DylanCoon99/multi-axis-arm/mechanical_design/gripper_ideas/gripper_3-1024x805.png

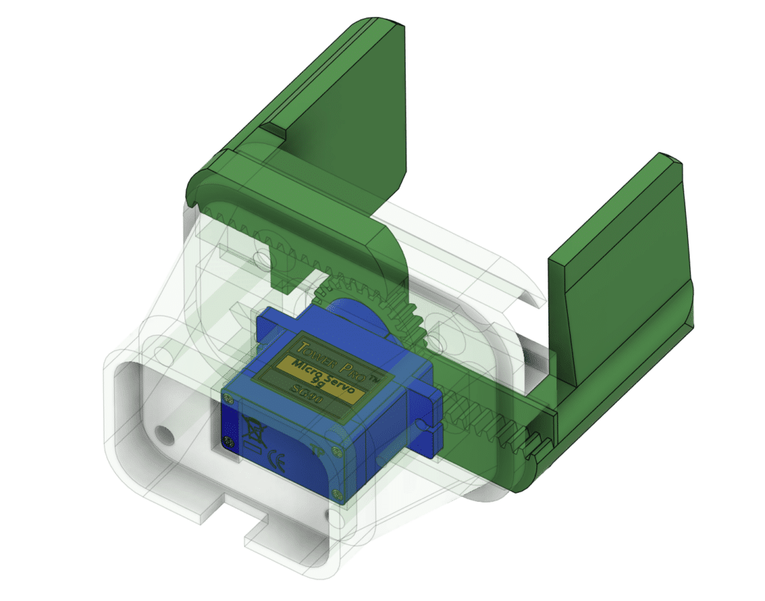
mechanical_design/gripper_ideas/gripper_3-1024x805.png
