DylanCoon99/multi-axis-arm/component_weights.xlsx

Component Weight Log — Week 1 Torque Calculation
Component | Estimated (g) | Measured (g) | Notes
Actuators
NEMA 17 stepper |  |  | Sits on base — not in torque calc
MG996R servo #1 (J2 shoulder) | 55 | 55
MG996R servo #2 (J2 shoulder) | 55 | 55
MG996R servo #3 (J3 elbow) | 55 | 55
SG90 / MG90S servo (gripper) | 9 | 9 | SG90 ~9g, MG90S ~13g
Spare MG996R |  |  | Not installed — exclude from calc
Structural (printed parts)
Upper arm link | 60 | 60 | Estimate — weigh after printing
Forearm link | 50 | 50 | Estimate — weigh after printing
Shoulder fork / joint housing
Elbow fork / joint housing
Gripper assembly (jaws + mount) | 70 | 70 | Total with servo
Base disc (printed pulley) |  |  | Not in torque calc
Base plate |  |  | Not in torque calc
Hardware
608ZZ bearing x2 |  | 12 | ~12g each
Metal servo horn x2
M3 fasteners (per joint, approx)
8mm stub shafts x2
Belt Drive (base — not in torque calc)
GT2 belt segment
20T GT2 pulley x2
Payload
Test object — light | 25
Test object — medium | 50
Test object — heavy | 100
Shoulder Torque Calculation (J2, dual MG996R) — Fill in after weighing
Upper arm link | 50 | 60
Elbow servo (MG996R) | 55 | 120
Forearm link | 50 | 185
Gripper assembly | 50 | 250
Payload | 50 | 260
TOTAL at shoulder | 50 | 270
Budget (50% of dual MG996R rating) |  |  | 10.00
Margin (positive = OK)
Margin (positive = OK)
