DylanCoon99/multi-axis-arm/mechanical_design/gcode/Arm Base.3mf

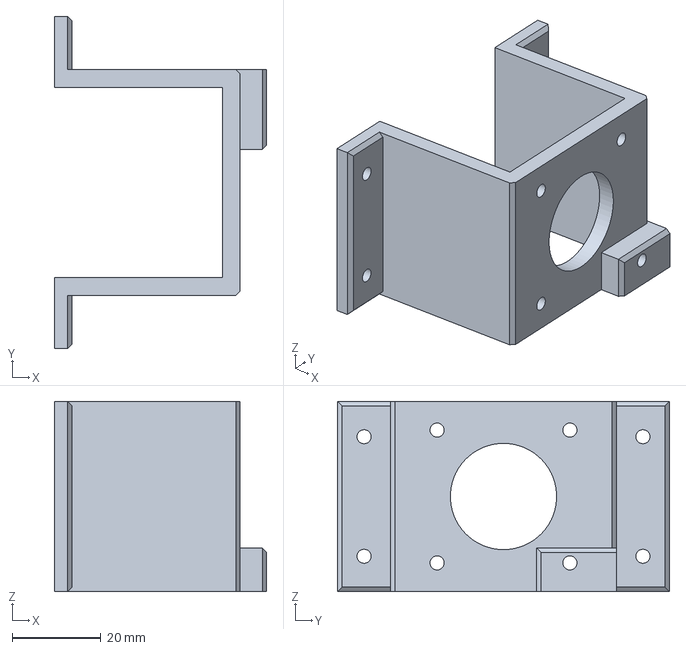
[picture p2: CAD file, 2026-09-03]
mechanical_design/gcode/Arm Base.3mf
48.0 x 75.0 x 43.0 mm
