DylanCoon99/multi-axis-arm/mechanical_design/projects/rack_and_pinion_test.3mf

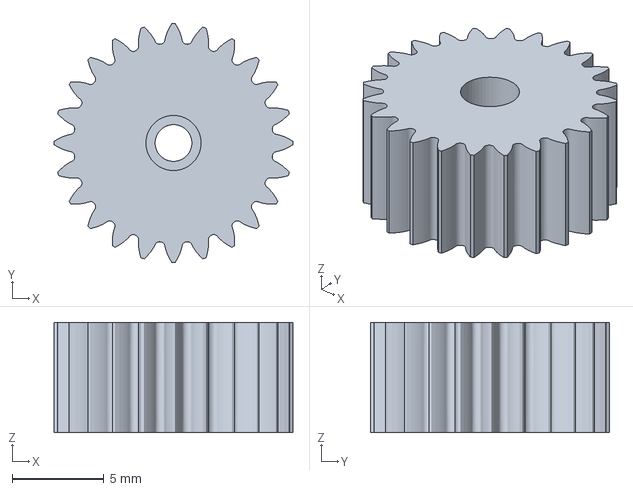
[picture p3: CAD file, 2026-09-18]
mechanical_design/projects/rack_and_pinion_test.3mf
13.0 x 13.0 x 6.00 mm
