DylanCoon99/multi-axis-arm/mechanical_design/stls/gripper_mount_b.stl

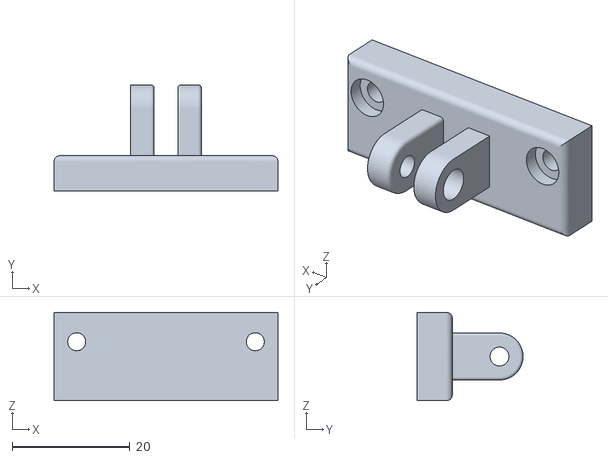
[picture p4: CAD file, 2026-09-18]
mechanical_design/stls/gripper_mount_b.stl
38.0 x 18.0 x 15.0
