DylanCoon99/multi-axis-arm/mechanical_design/stls/gripper_housing.stl

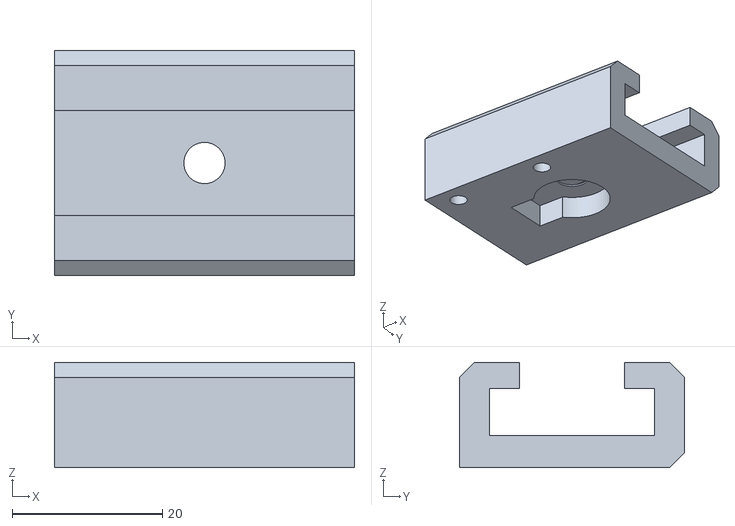
[picture p5: CAD file, 2026-09-18]
mechanical_design/stls/gripper_housing.stl
40.0 x 30.0 x 14.0
