DylanCoon99/multi-axis-arm/mechanical_design/projects/L1.3mf

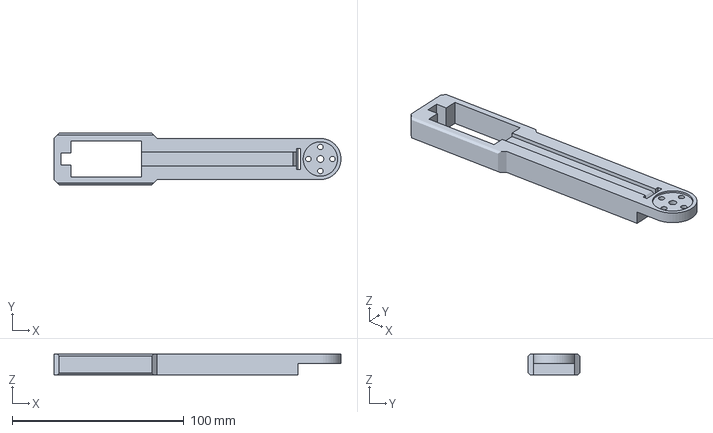
[picture p6: CAD file, 2026-09-12]
mechanical_design/projects/L1.3mf
167.0 x 30.0 x 12.0 mm
