DylanCoon99/multi-axis-arm/mechanical_design/stls/rack.stl

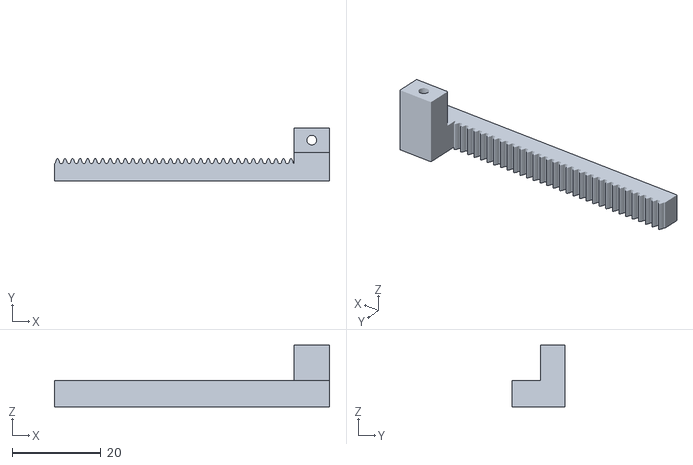
[picture p7: CAD file, 2026-09-18]
mechanical_design/stls/rack.stl
62.1 x 12.0 x 14.0
