DylanCoon99/multi-axis-arm/mechanical_design/projects/L2.3mf

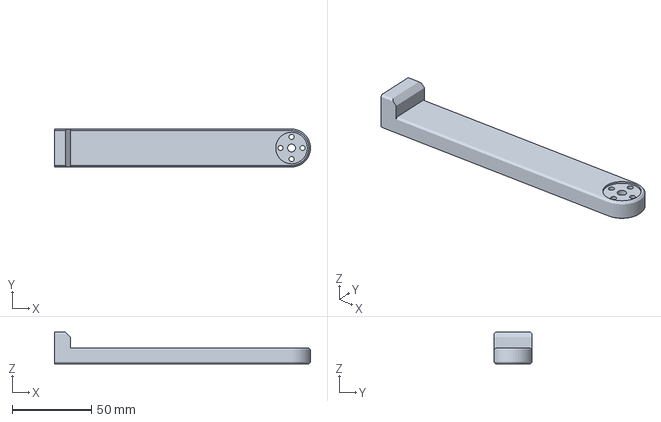
[picture p8: CAD file, 2026-09-12]
mechanical_design/projects/L2.3mf
162.0 x 24.0 x 20.0 mm
