DylanCoon99/multi-axis-arm/mechanical_design/projects/j2_plate.3mf

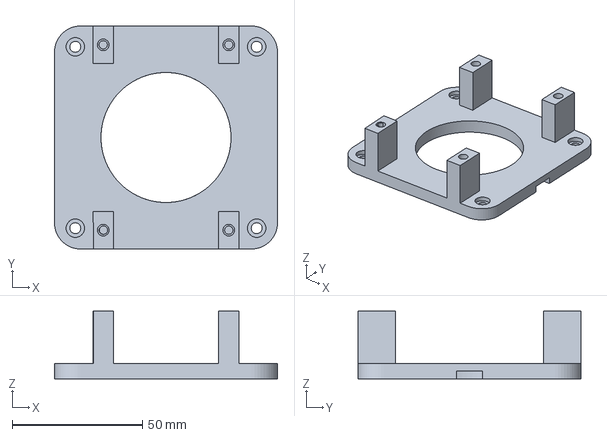
[picture p9: CAD file, 2026-09-10]
mechanical_design/projects/j2_plate.3mf
85.8 x 85.8 x 26.1 mm
