DylanCoon99/multi-axis-arm/mechanical_design/stls/servo_mount.stl

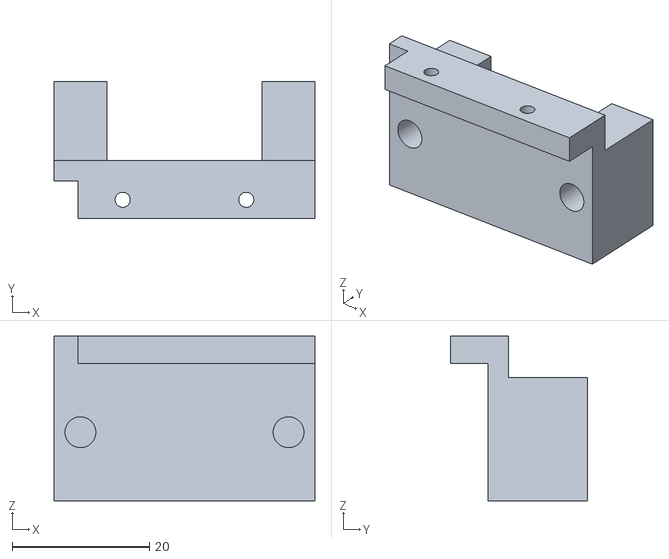
[picture p10: CAD file, 2026-09-18]
mechanical_design/stls/servo_mount.stl
38.0 x 20.0 x 24.0
