DylanCoon99/multi-axis-arm/mechanical_design/projects/base.3mf

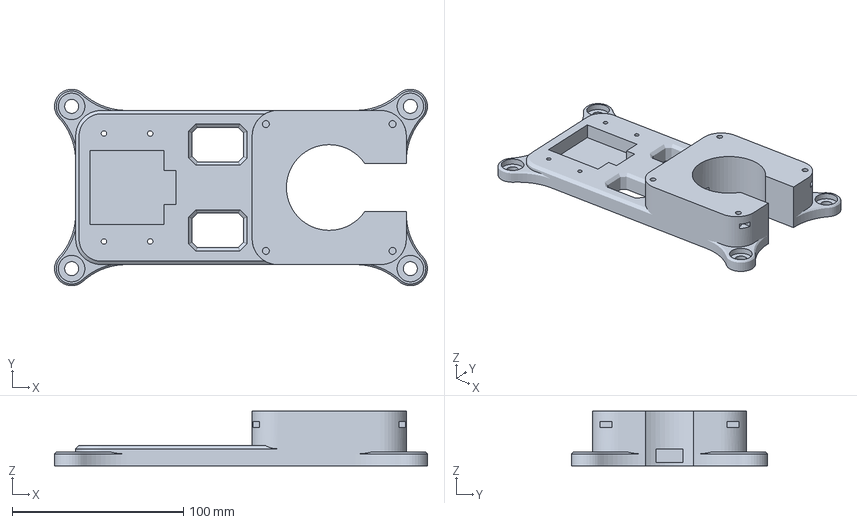
[picture p11: CAD file, 2026-09-07]
mechanical_design/projects/base.3mf
217.7 x 114.7 x 32.0 mm
