DylanCoon99/multi-axis-arm/mechanical_design/stls/rack_test.stl

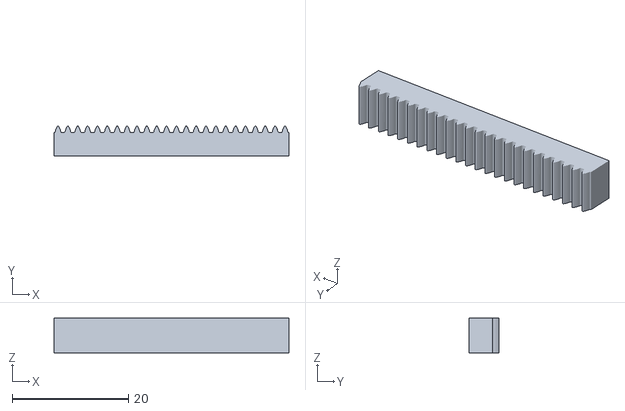
[picture p12: CAD file, 2026-09-18]
mechanical_design/stls/rack_test.stl
40.5 x 5.12 x 6.00
