DylanCoon99/multi-axis-arm/mechanical_design/projects/Bearing Mount.3mf

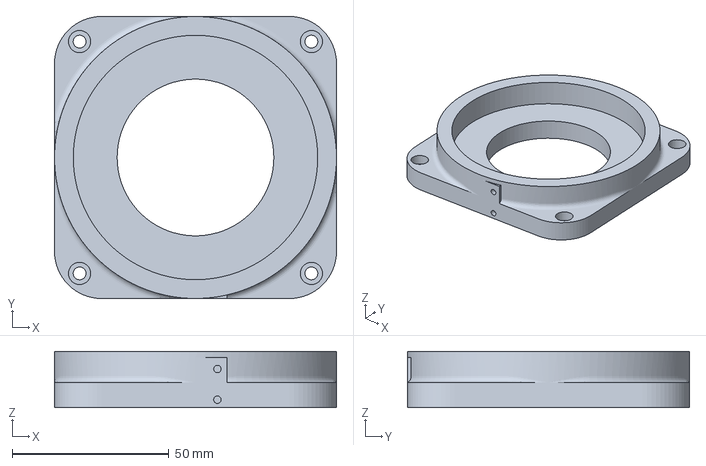
[picture p13: CAD file, 2026-09-06]
mechanical_design/projects/Bearing Mount.3mf
90.0 x 90.0 x 17.9 mm
