DylanCoon99/multi-axis-arm/mechanical_design/projects/test link - j2.3mf

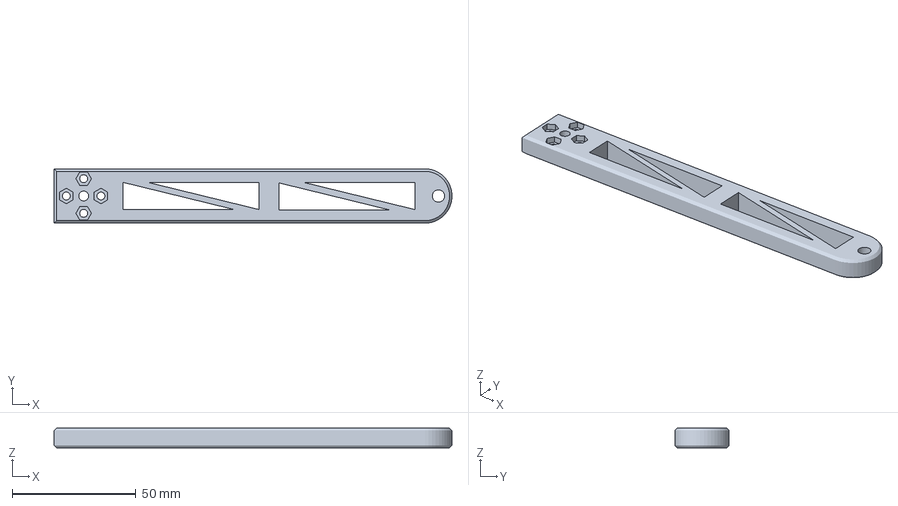
[picture p14: CAD file, 2026-09-06]
mechanical_design/projects/test link - j2.3mf
161.0 x 22.0 x 8.00 mm
