DylanCoon99/multi-axis-arm/mechanical_design/stls/gear_updated.stl

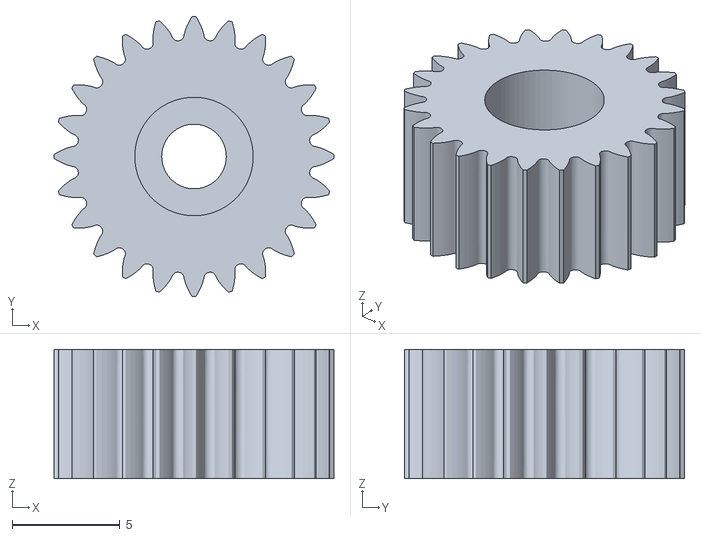
[picture p15: CAD file, 2026-09-18]
mechanical_design/stls/gear_updated.stl
13.0 x 13.0 x 6.00
