DylanCoon99/multi-axis-arm/mechanical_design/projects/belt tensioner.3mf

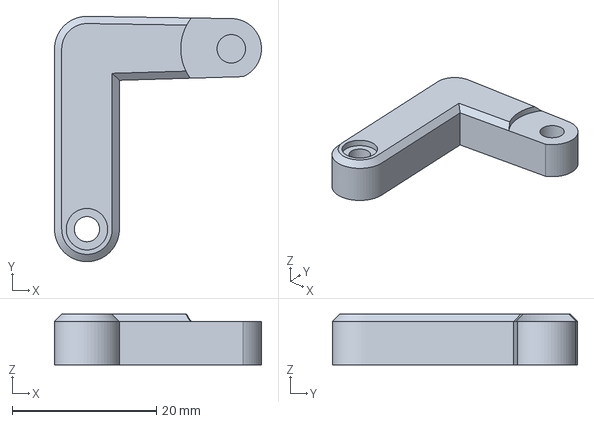
[picture p16: CAD file, 2026-09-06]
mechanical_design/projects/belt tensioner.3mf
28.7 x 34.0 x 7.00 mm
