DylanCoon99/multi-axis-arm/mechanical_design/stls/gripper_face.stl

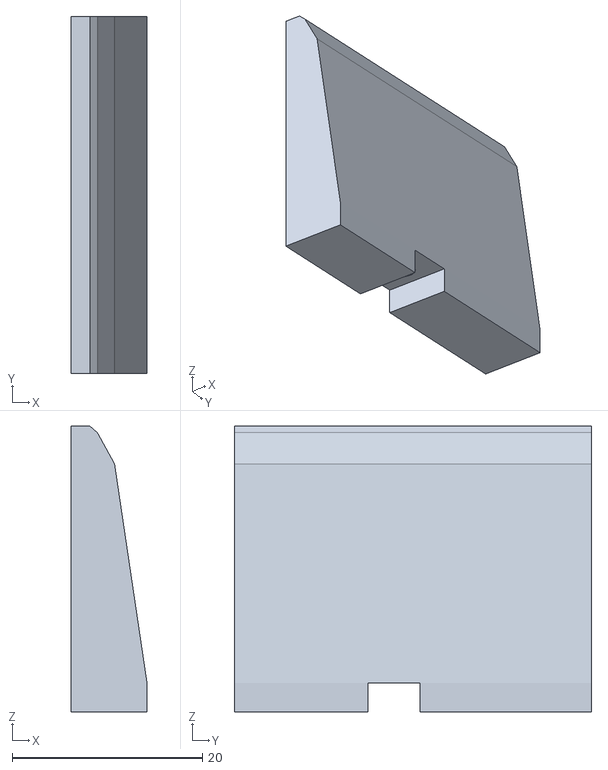
[picture p17: CAD file, 2026-09-18]
mechanical_design/stls/gripper_face.stl
8.00 x 37.5 x 30.0
