DylanCoon99/multi-axis-arm/mechanical_design/stls/gripper_mount_a.stl

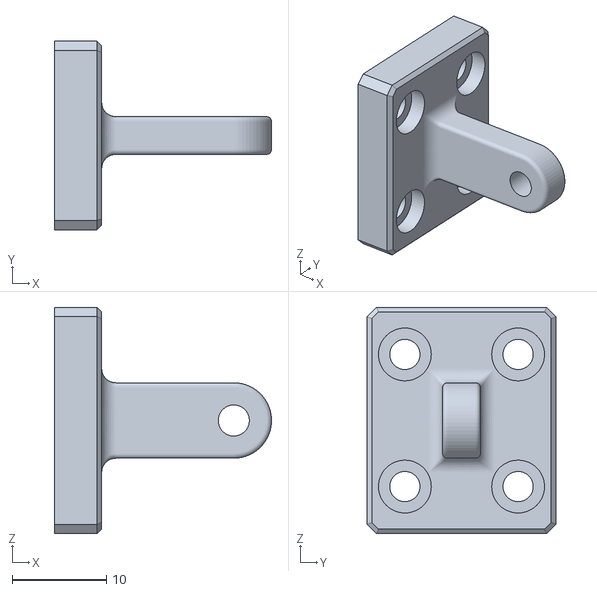
[picture p18: CAD file, 2026-09-18]
mechanical_design/stls/gripper_mount_a.stl
23.0 x 20.0 x 24.0
