DylanCoon99/multi-axis-arm/mechanical_design/projects/stepper_motor_project.3mf

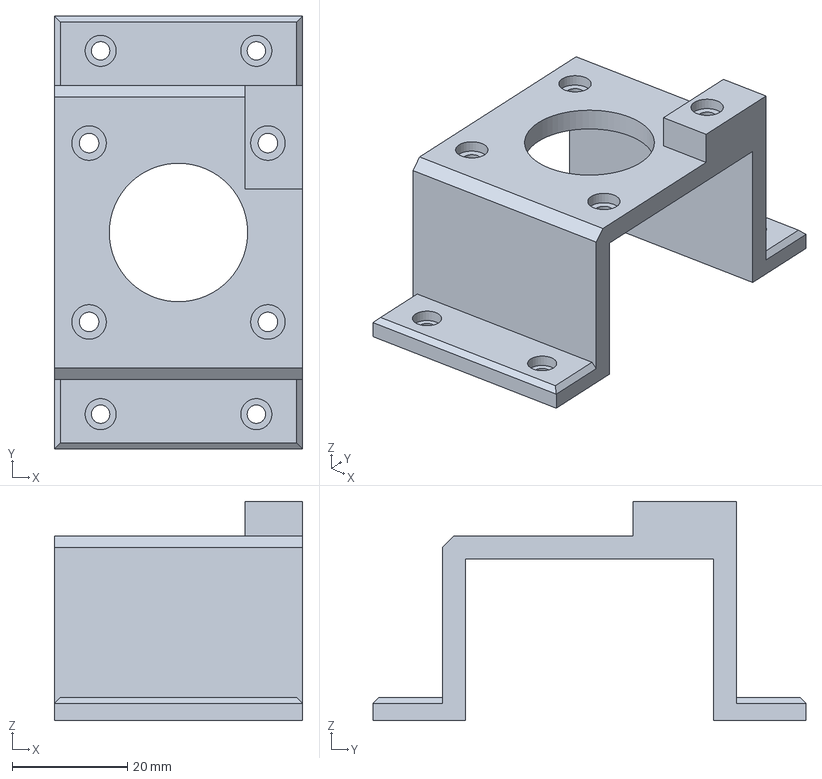
[picture p19: CAD file, 2026-09-05]
mechanical_design/projects/stepper_motor_project.3mf
43.0 x 75.0 x 38.0 mm
