DylanCoon99/multi-axis-arm/mechanical_design/stls/servo_mount_plate.stl

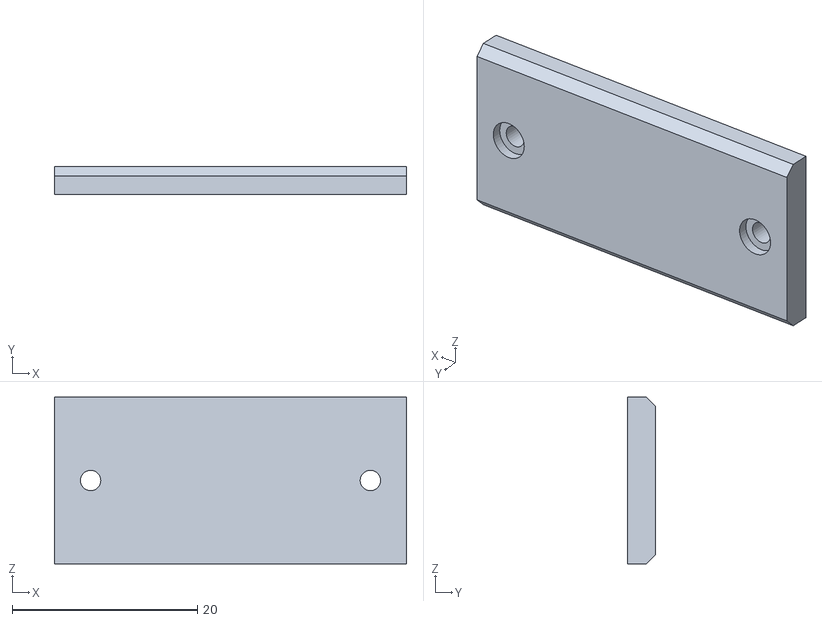
[picture p20: CAD file, 2026-09-18]
mechanical_design/stls/servo_mount_plate.stl
38.0 x 3.00 x 18.0
