DylanCoon99/multi-axis-arm/mechanical_design/projects/stepper_mount_templates.3mf

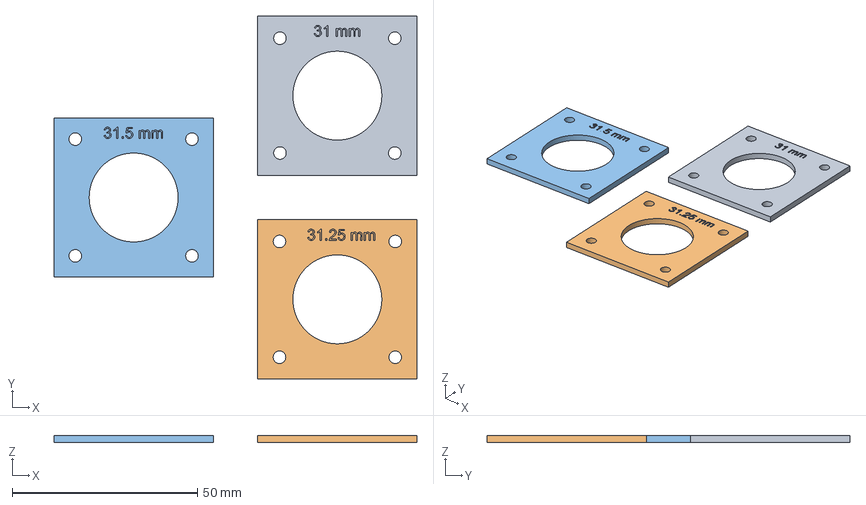
[picture p21: CAD file, 2026-09-03]
mechanical_design/projects/stepper_mount_templates.3mf
98.0 x 98.0 x 2.00 mm
stepper_mount_template_31mm.stl
stepper_mount_template_31_25mm.stl
stepper_mount_template_31_5mm.stl
