DylanCoon99/multi-axis-arm/mechanical_design/stls/link_1_fork_2.stl

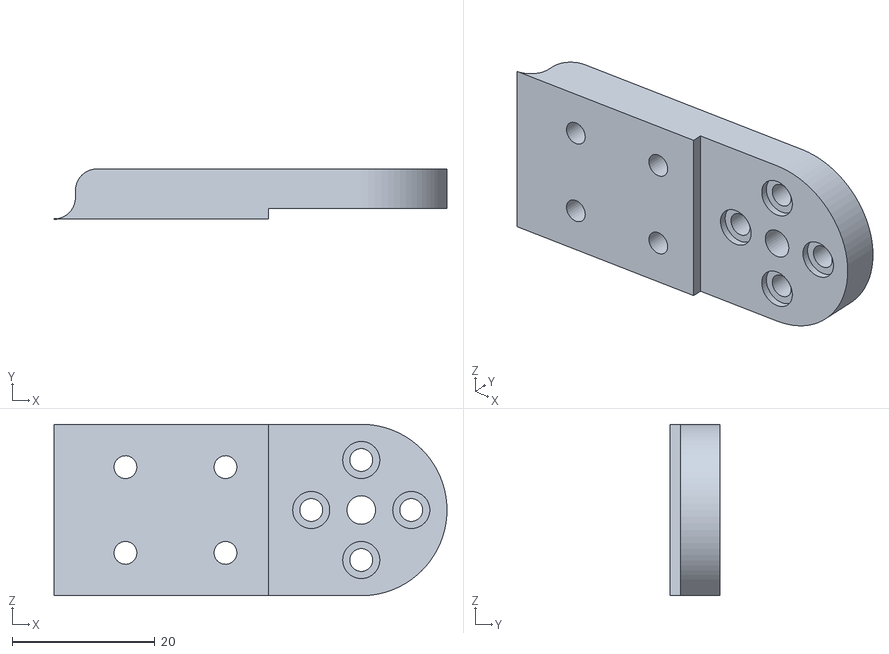
[picture p22: CAD file, 2026-09-10]
mechanical_design/stls/link_1_fork_2.stl
55.0 x 7.00 x 24.0
