DylanCoon99/multi-axis-arm/mechanical_design/stls/L1.stl

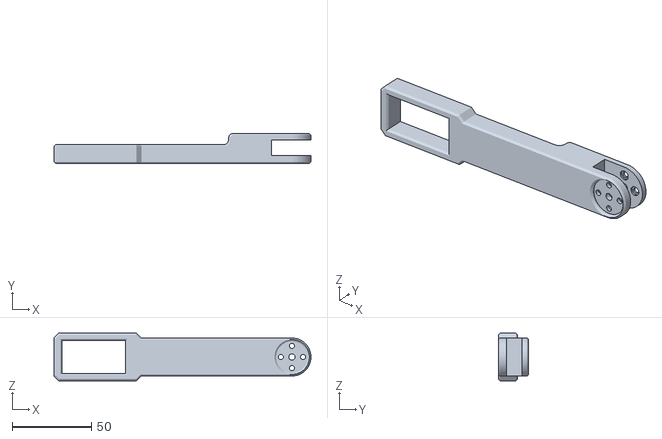
[picture p23: CAD file, 2026-09-10]
mechanical_design/stls/L1.stl
162.0 x 19.0 x 30.0
