DylanCoon99/multi-axis-arm/mechanical_design/stls/tension rod.stl

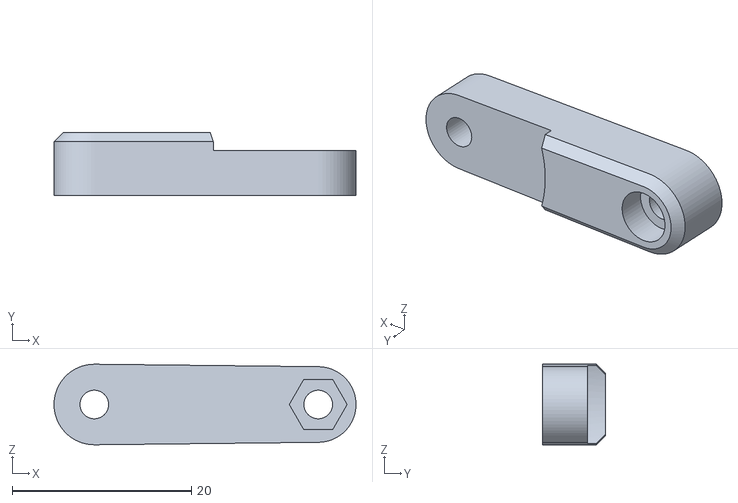
[picture p24: CAD file, 2026-09-07]
mechanical_design/stls/tension rod.stl
33.7 x 7.00 x 9.00
