DylanCoon99/multi-axis-arm/mechanical_design/stls/tension shroud.stl

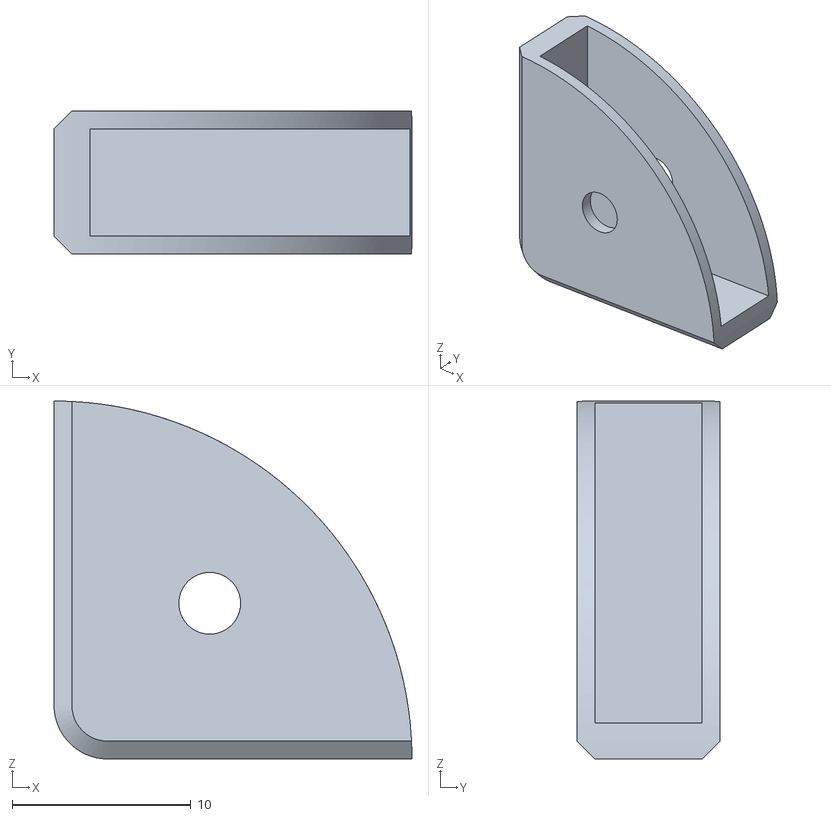
[picture p25: CAD file, 2026-09-07]
mechanical_design/stls/tension shroud.stl
20.0 x 8.00 x 20.0
