DylanCoon99/multi-axis-arm/mechanical_design/stls/base_plate_final.stl

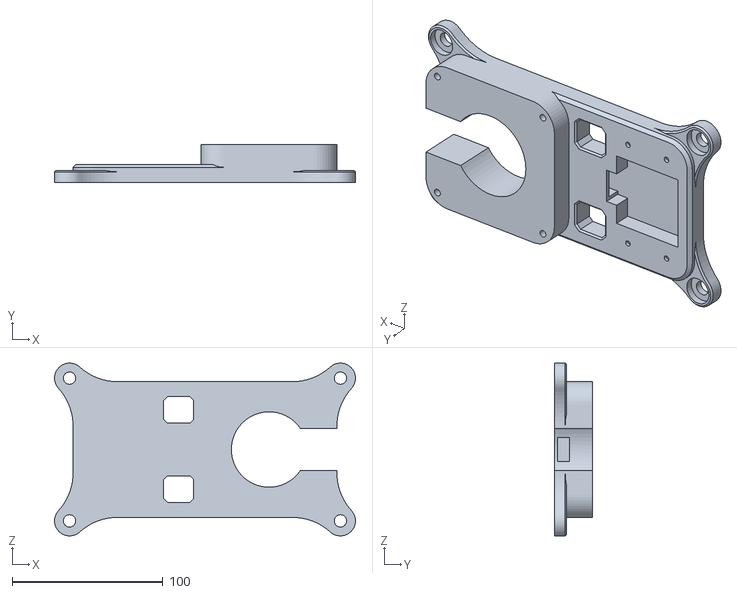
[picture p26: CAD file, 2026-09-06]
mechanical_design/stls/base_plate_final.stl
199.7 x 25.0 x 114.6
