DylanCoon99/multi-axis-arm/mechanical_design/stls/bearing test fit inner.stl

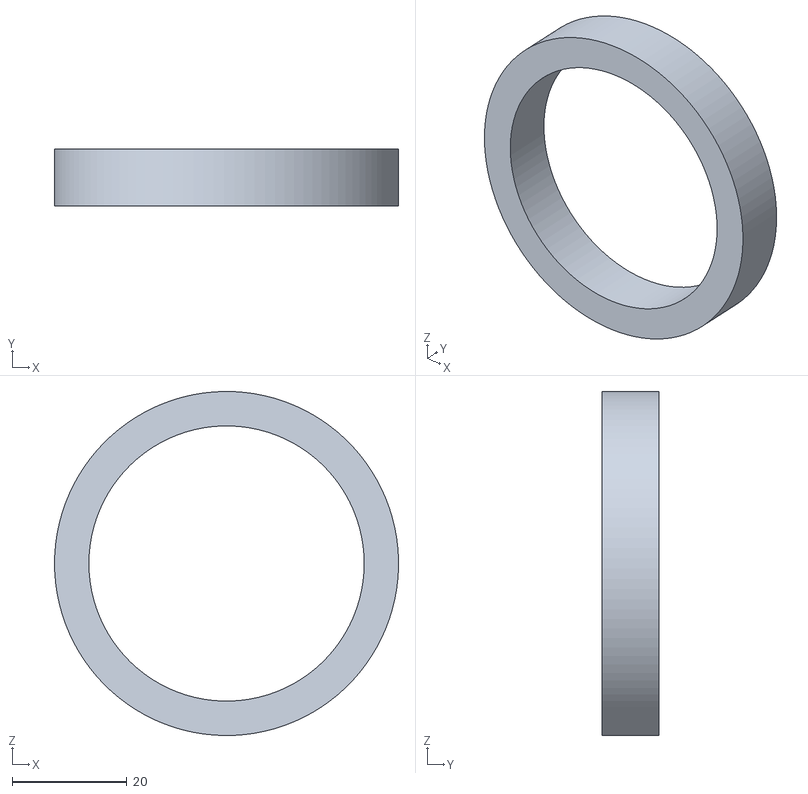
[picture p27: CAD file, 2026-09-06]
mechanical_design/stls/bearing test fit inner.stl
60.0 x 10.0 x 60.0
