DylanCoon99/multi-axis-arm/mechanical_design/stls/bearing gear mount.stl

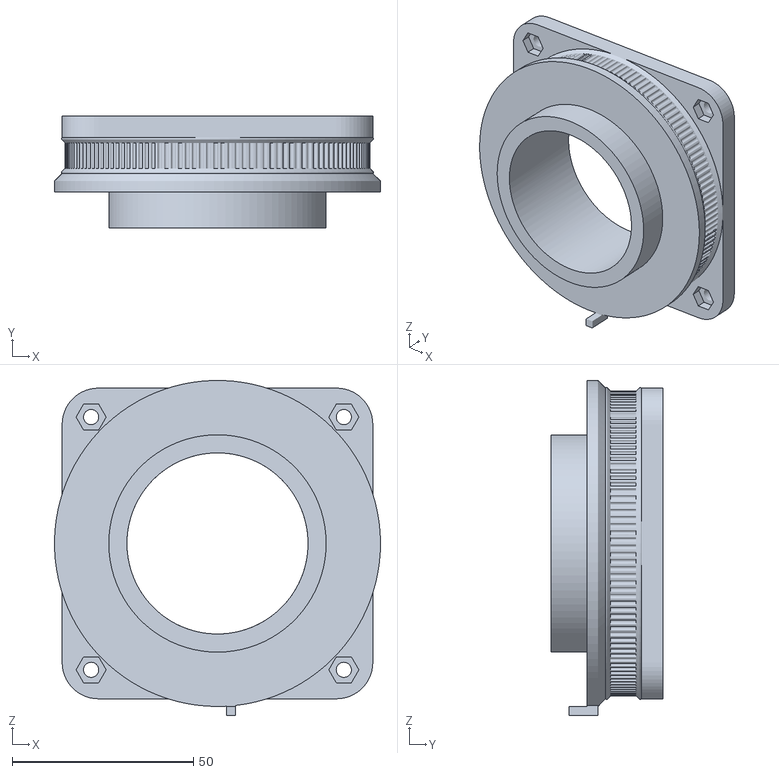
[picture p28: CAD file, 2026-09-06]
mechanical_design/stls/bearing gear mount.stl
90.0 x 31.1 x 92.5
