DylanCoon99/multi-axis-arm/mechanical_design/stls/bearing test fit.stl

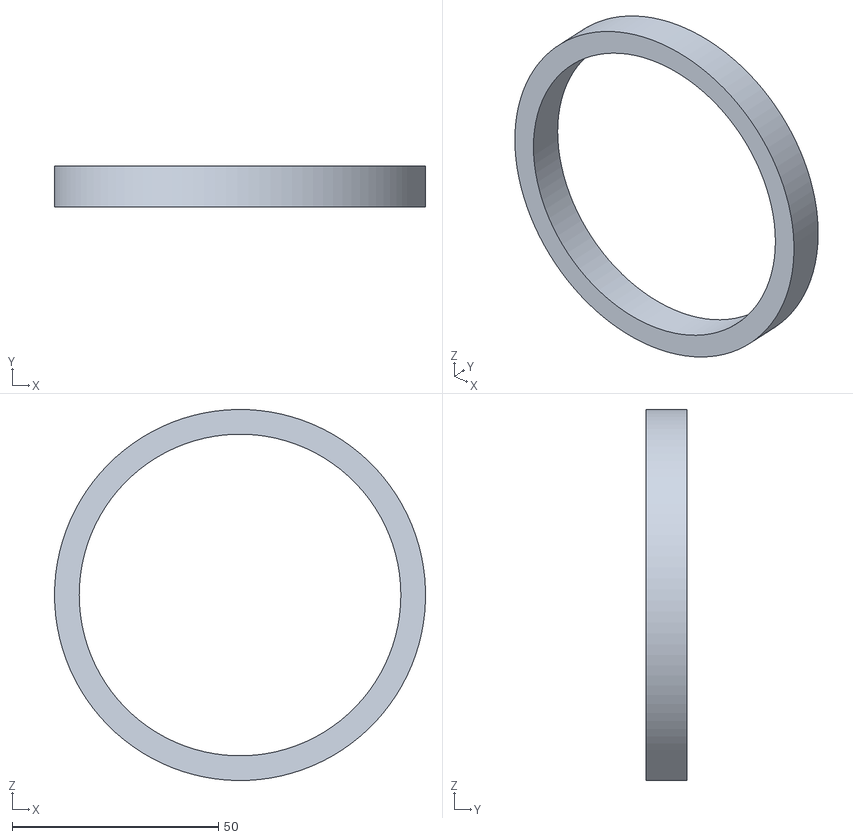
[picture p29: CAD file, 2026-09-06]
mechanical_design/stls/bearing test fit.stl
90.0 x 10.0 x 90.0
