DylanCoon99/multi-axis-arm/mechanical_design/stls/servo test bracket.stl

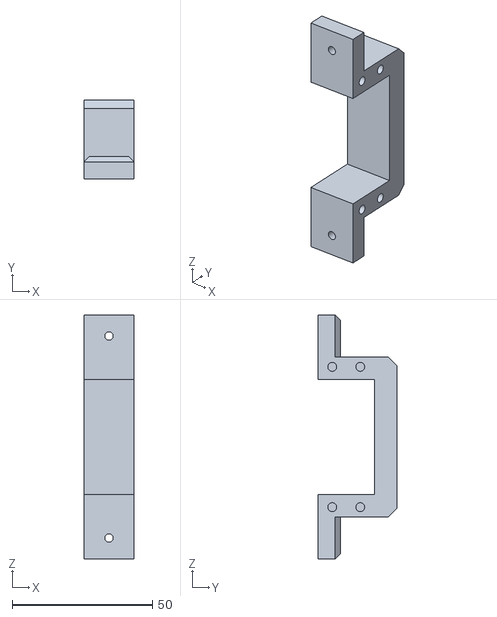
[picture p30: CAD file, 2026-09-06]
mechanical_design/stls/servo test bracket.stl
18.0 x 28.0 x 87.0
