DylanCoon99/multi-axis-arm/mechanical_design/stls/stepper_mount_template_31_5mm.stl

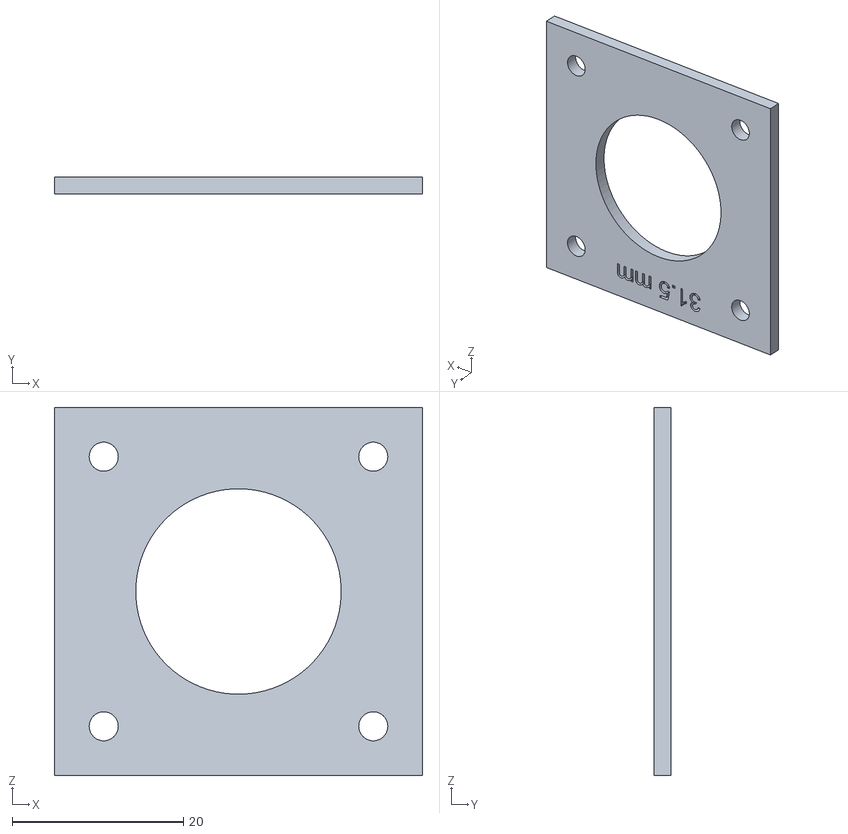
[picture p31: CAD file, 2026-09-03]
mechanical_design/stls/stepper_mount_template_31_5mm.stl
43.0 x 2.00 x 43.0
