DylanCoon99/multi-axis-arm/mechanical_design/stls/tensioner_test_base.stl

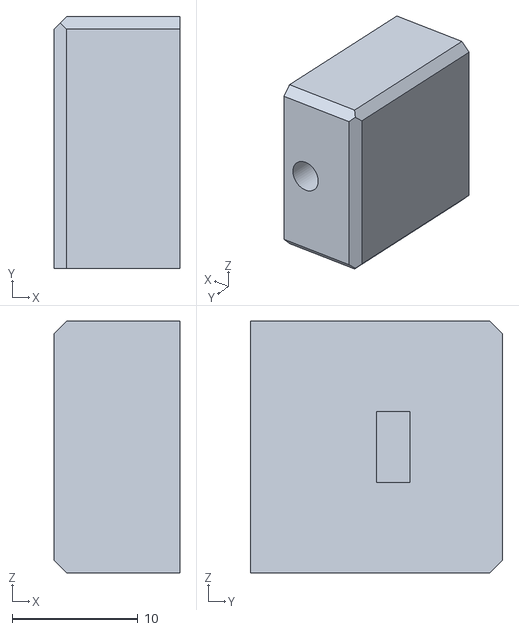
[picture p32: CAD file, 2026-09-02]
mechanical_design/stls/tensioner_test_base.stl
10.0 x 20.0 x 20.0
