DylanCoon99/multi-axis-arm/mechanical_design/stls/Arm Base.stl

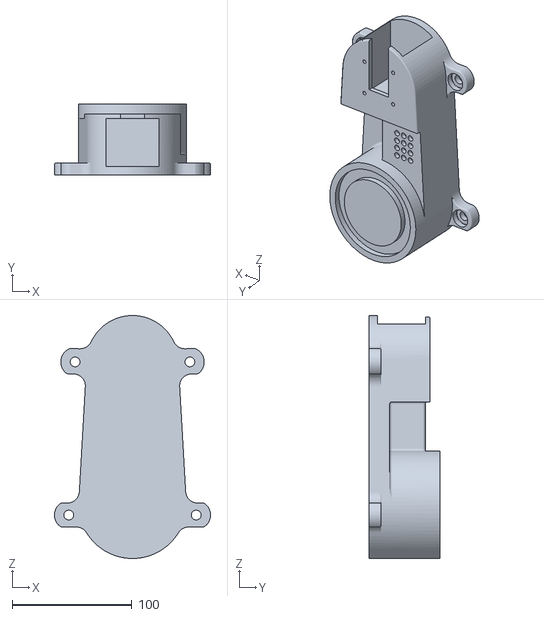
[picture p33: CAD file, 2026-08-31]
mechanical_design/stls/Arm Base.stl
130.5 x 59.0 x 203.2
