DylanCoon99/multi-axis-arm/(list of files, cad)

Other CAD files:
mechanical_design/projects/gripper_housing.3mf
mechanical_design/stls/rack_thicker.stl
mechanical_design/stls/pinion_test.stl
mechanical_design/projects/bearing gear mount.3mf
mechanical_design/stls/rack_updated.stl
mechanical_design/stls/link 2.stl
mechanical_design/stls/l1_fork_1.stl
mechanical_design/stls/j2_plate.stl
mechanical_design/stls/Link_1_fork_1.stl
mechanical_design/stls/base.stl
mechanical_design/stls/tensioner_with_bend.stl
mechanical_design/stls/test link.stl
mechanical_design/stls/bearing mount.stl
mechanical_design/stls/motor mount.stl
mechanical_design/stls/stepper_mount_template_31_25mm.stl
mechanical_design/stls/stepper_mount_template_31mm.stl
mechanical_design/stls/stepper motor mount.stl
mechanical_design/stls/tensioner.stl
mechanical_design/projects/m4_nut_test.3mf
mechanical_design/stls/j2 plate.stl
mechanical_design/stls/m4_nut_test.stl
mechanical_design/stls/nut_fit_test.stl
mechanical_design/stls/stepper_motor_mount.stl
