DylanCoon99/multi-axis-arm/(commit log)

2026-08-31 committing plan
    [Arm Base.stl]
2026-09-01 J2 redesign; torque calculations
    [component_weights.xlsx]
2026-09-02 belt tensioner design; stepper motor driver test
    [Arm Base.3mf, tensioner.stl, tensioner_test_base.stl]
2026-09-03 updated motor mount design
    [Arm Base.3mf, motor mount.stl, stepper motor mount.stl, stepper_motor_mount.stl, stepper_motor_project.3mf, stepper_mount_template_31_25mm.stl, stepper_mount_template_31_5mm.stl, stepper_mount_template_31mm.stl]
2026-09-05 updated plan
    [base.3mf, base.stl, stepper_motor_project.3mf]
2026-09-06 software setup
    [Bearing Mount.3mf, base_plate_final.stl, bearing gear mount.3mf, bearing gear mount.stl, bearing mount.stl, bearing test fit inner.stl, bearing test fit.stl, belt tensioner.3mf]
2026-09-07 config layout
    [base.3mf, base.stl, tension rod.stl, tension shroud.stl]
2026-09-08 torque test for mg996r servo complete
    [j2 plate.stl, j2_plate.3mf, servo_mount.stl]
2026-09-10 J2 dual servo test
    [L1.3mf, L1.stl, Link_1_fork_1.stl, j2_plate.3mf, j2_plate.stl, l1_fork_1.stl, link_1_fork_2.stl]
2026-09-12 test j2 and j3
    [L1.3mf, L2.3mf, link 2.stl]
2026-09-12 servo.py done
2026-09-12 stepper joint implementation
2026-09-13 robot and joint interface done
2026-09-13 all 3 joint test
2026-09-18 updated checklist; updated project scope
    [gear_updated.stl, gripper_face.stl, gripper_housing.3mf, gripper_housing.stl, gripper_mount_a.stl, gripper_mount_b.stl, pinion_test.stl, rack.stl]
